CindyPotvin/TemperatureLogger_ESP-12F/README.md

# TemperatureLogger_ESP-12F
Temperature logging PCB in KiCad based on ESP8266 (ESP-12F)
