CindyPotvin/TemperatureLogger_ESP-12F/parts.txt

Enclosure sensor
https://www.aliexpress.com/item/10-pieces-59-26-12mm-szomk-hot-sales-humidity-sensor-instrument-enclosure-abs-electronics-plastic-enclosure/32678983293.html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

Enclosure circuit
https://www.aliexpress.com/item/32982177498.html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

C1 1uf
C2 1uf
FG18X7R1E105KRT00
https://www.mouser.ca/ProductDetail/810-FG18X7R1E105KRT0

J2 I2C header
M20-9990246 
https://www.mouser.ca/ProductDetail/Harwin/M20-9990246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

J3 Power
M20-9990246  
https://www.mouser.ca/ProductDetail/Harwin/M20-9990246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

R1 2,7k
R2 2,7k
MFS1/4DCT52R2701F 
https://www.mouser.ca/ProductDetail/KOA-Speer/MFS1-4DCT52R2701F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

R3 10k
R4 10k
R5 10k
R6 10k
MF1/4LCT52R332J 
https://www.mouser.ca/ProductDetail/KOA-Speer/MF1-4LCT52R332J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

R7 100
MF1/4LCT52R101G 
https://www.mouser.ca/ProductDetail/KOA-Speer/MF1-4LCT52R101G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

SW1 Switch to reset
B3F-1000 
https://www.mouser.ca/ProductDetail/Omron-Electronics/B3F-1000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

SW2 Switch to program
EG1218 
https://www.mouser.ca/ProductDetail/E-Switch/EG1218?qs=sGAEpiMZZMtHXLepoqNyVZDOWY7elTCOE4MJ3sXRkSs%3D

U1 Power regulator 3.3V
MCP1702-3302E/TO 
https://www.mouser.ca/ProductDetail/Microchip-Technology/MCP1702-3302E-TO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

U3 ESP8266 ESP-12F
https://www.ebay.ca/itm/ESP-12F-ESP8266-Remote-Serial-WIFI-Transceiver-Wireless-Adapter-Plate-Module/264051129457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

U4 FTDI Cable socket
J1 Power additionnal devices
M20-9770346
https://www.mouser.ca/ProductDetail/Harwin/M20-9770346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

U6 BMP-280 and 4 pin header M20-9770446 
https://www.ebay.ca/itm/BMP280-3-3V-Pressure-Sensor-Module-High-Precision-Atmospheric-Arduino-BMP180/201511252133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
https://www.mouser.ca/ProductDetail/855-M20-9770446

LED1 LED LiteOn LTL2R3KGD-EM + led mounting hardware spacer
https://www.mouser.ca/ProductDetail/Lite-On/LTL2R3KGD-EM?qs=sGAEpiMZZMtmwHDZQCdlqY3QuPVQdrfivxVgVo2hFbg%3D
https://www.mouser.ca/new/Wurth-Electronics/wurth-wa-sled-spacers/
