CindyPotvin/TemperatureLogger_ESP-12F/TemperatureLogger_ESP-12F.kicad_pcb

## KiCad design TemperatureLogger_ESP-12F.kicad_pcb (2020-02-16)

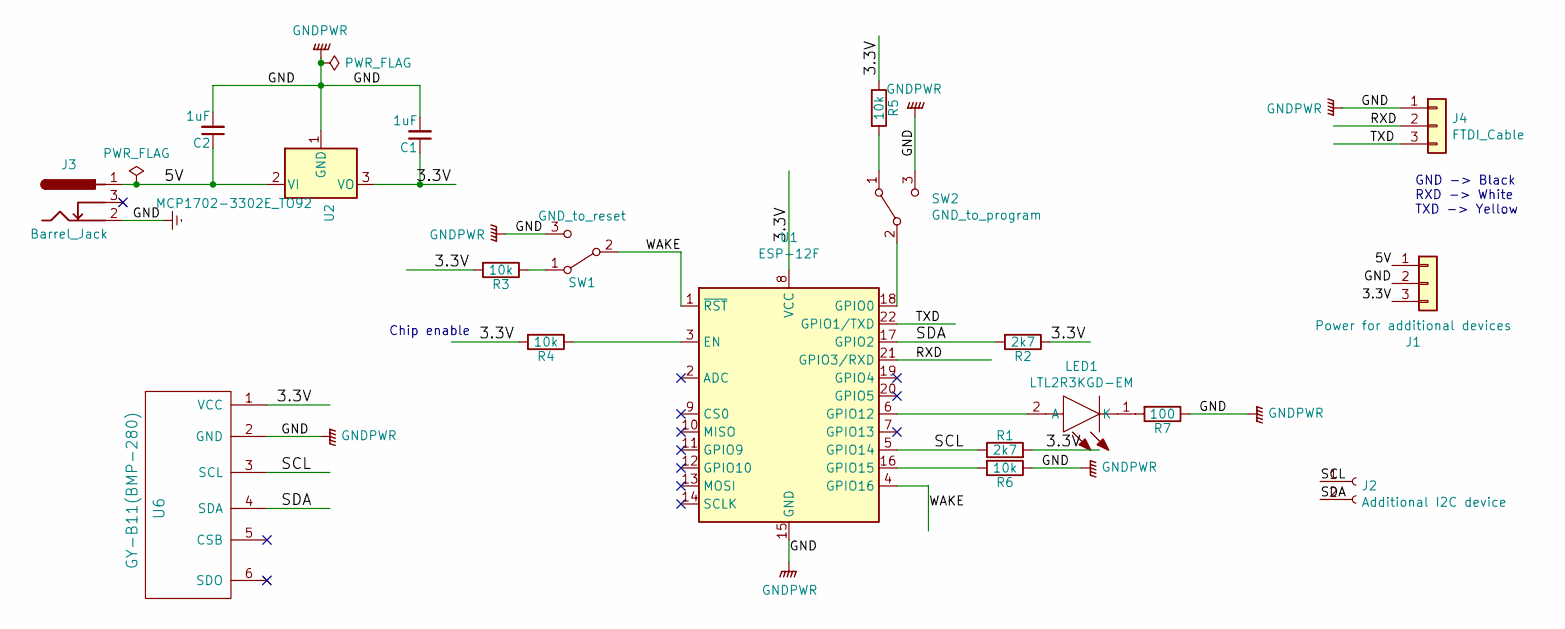
[picture p1: schematic TemperatureLogger_ESP-12F.sch]

Parts:
C1, C2: 1uF; FG18X7R1H334KRT00
J1: Power for additional devices; PinHeader_1x03_P2.54mm_Vertical
J2: Additional I2C device; PinHeader_1x02_P2.54mm_Vertical
J3: Barrel_Jack; PinHeader_1x02_P2.54mm_Vertical
J4: FTDI_Cable; PinHeader_1x03_P2.54mm_Vertical
LED1: LTL2R3KGD-EM; LTL2R3KGDEM; Mouser Part Number 859-LTL2R3KGD-EM
R1, R2: 2k7; R_Axial_DIN0204_L3.6mm_D1.6mm_P2.54mm_Vertical
R3, R4, R5, R6: 10k; R_Axial_DIN0207_L6.3mm_D2.5mm_P2.54mm_Vertical
R7: 100; R_Axial_DIN0204_L3.6mm_D1.6mm_P2.54mm_Vertical
SW1: GND_to_reset; B3F-1000
SW2: GND_to_program; EG1218
U1: ESP-12F; ESP-12E
U2: MCP1702-3302E_TO92; TO-92_Inline
U6: GY-B11(BMP-280); PinHeader_1x04_P2.54mm_Vertical

Connections:
/3.3V: C1.1, J1.3, R1.2, R2.1, R3.2, R4.2, R5.1, U1.8 (VCC), U2.3 (VO), U6.1 (VCC)
/5V: C2.1, J1.1, J3.1, U2.2 (VI)
/RXD: J4.2, U1.21 (GPIO3/RXD)
/SCL: J2.1, R1.1, U1.5 (GPIO14), U6.3 (SCL)
/SDA: J2.2, R2.2, U1.17 (GPIO2), U6.4 (SDA)
/TXD: J4.3, U1.22 (GPIO1/TXD)
/WAKE: SW1.2 (B), U1.1 (~RST), U1.4 (GPIO16)
Earth: C1.2, C2.2, J1.2, J3.2, J4.1, R6.1, R7.1, SW1.3 (C), SW2.3 (C), U1.15 (GND), U2.1 (GND), U6.2 (GND)
unnamed: LED1.1 (K), R7.2
unnamed: LED1.2 (A), U1.6 (GPIO12)
unnamed: R3.1, SW1.1 (A)
unnamed: R4.1, U1.3 (EN)
unnamed: R5.2, SW2.1 (A)
unnamed: R6.2, U1.16 (GPIO15)
unnamed: SW2.2 (B), U1.18 (GPIO0)

Notes on the sheet:
Chip enable
GND -> Black RXD -> White TXD -> Yellow

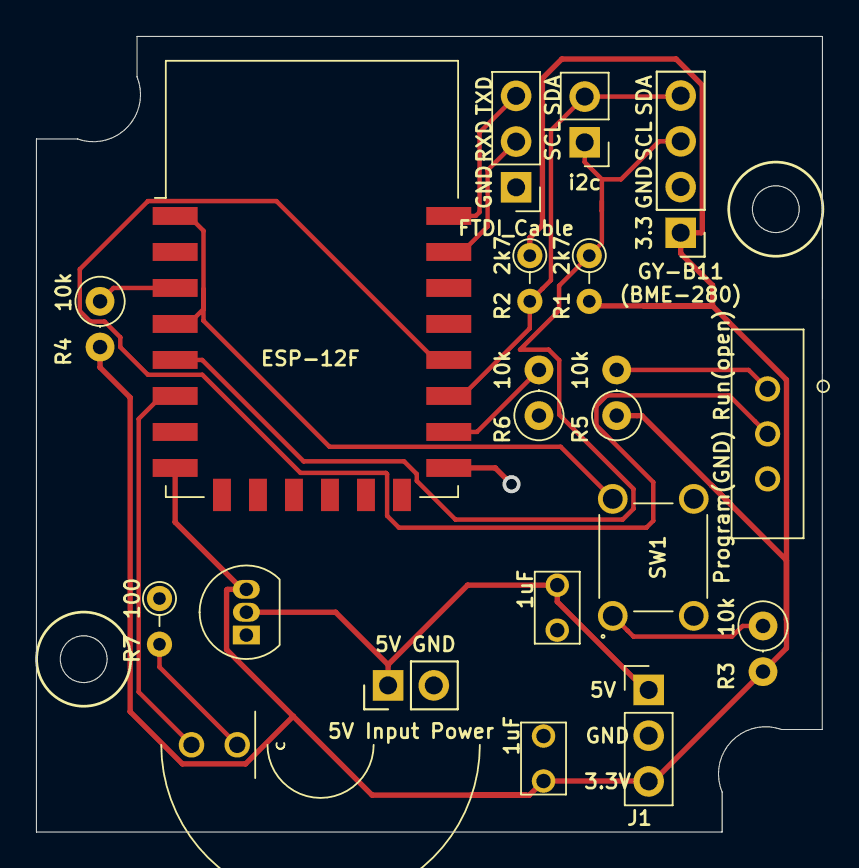
[picture p2: board TemperatureLogger_ESP-12F.kicad_pcb from above]

Board: 2 copper layers, 43.7 x 44.2 mm, 19 parts (0 on the bottom side), 15 nets.
