CindyPotvin/TemperatureLogger_ESP-12F/(commit log)

2019-07-07 PCB sent to production for the temperature logging modules in Kicad
    [TempLogger2-B_Cu.gbl, TempLogger2-B_Mask.gbs, TempLogger2-B_Paste.gbp, TempLogger2-Edge_Cuts.gm1, TempLogger2-F_Cu.gtl, TempLogger2-F_Mask.gts, TempLogger2-F_Paste.gtp, TempLogger2-F_SilkS.gto]
2019-07-20 Adjusted BMP-280 footprint that was pointing to the wrong library
    [TemperatureLogger_ESP-12F.kicad_pcb, TemperatureLogger_ESP-12F.sch]
2019-11-23 Fixing the programming switch and starting to change the DC jack to fit in the box (component still too high)
    [TemperatureLogger_ESP-12F.kicad_pcb]
2019-12-01 New revisions with headers for power and external sensor
    [TempLogger2-B_Cu.gbl, TempLogger2-B_Mask.gbs, TempLogger2-B_Paste.gbp, TempLogger2-Edge_Cuts.gm1, TempLogger2-F_Cu.gtl, TempLogger2-F_Mask.gts, TempLogger2-F_Paste.gtp, TempLogger2-F_SilkS.gto]
2019-12-02 Changing the linear regulator to the right one on the schematic to be able to use 9V batteries
    [TemperatureLogger_ESP-12F.sch, _saved_TemperatureLogger_ESP-12F.sch]
2020-02-16 Correcting SDA to use GPIO14 instead of pin 14 of ESP8266
    [TemperatureLogger_ESP-12F.kicad_pcb, TemperatureLogger_ESP-12F.sch]
